CircuitCo/BeagleBone-LCD7/(commit log)

2012-03-15 rm obsolete
    [BeagleBone-LCD7-RevA1-bom.xls, BeagleBone-LCD7-RevA1-schematic.dsn]
2012-04-23 rm old sch
    [BeagleBone-LCD7-RevA1-bom.xls, BeagleBone-LCD7-RevA1-schematic.dsn]
